elohhim/wyse-5070-ethernet-adapter/wyse-cnd-tek-adapter.scad

//
// File:    wyse-cnd-tek-adapter.scad
// Project: Dell Wyse 5070 2nd Ethernet Adapter Adapter
// Desc:    Adapter that holds CND-TEK T-shaped NIC daughter board
//

use <cnd-tek-nic.scad>
include <wyse-ethernet.scad>
