elohhim/wyse-5070-ethernet-adapter/(commit log)

2026-05-04 Add CND-TEK NIC adapter
    T-shaped PCB (30x20mm, 4.5mm wide x 11mm deep cutouts) with
    16x16x11mm ethernet jack. Includes NIC mock-up, adapter, and
    build integration.
    [cnd-tek-nic.scad, wyse-cnd-tek-adapter.scad, wyse-ethernet.scad]
2026-05-04 Update CND-TEK NIC with precise measurements
    PCB 30.6x20.1mm, 1.6mm thick. Ethernet jack 16.2x15x11.2mm.
    Wide section 8.8mm deep. Adjusted baffle height for thicker PCB.
    [cnd-tek-nic.scad, wyse-ethernet.scad]
2026-05-04 Switch CND-TEK to dual side snaps to clear flat cable connector
    Center snap would collide with the flat cable plug 1mm from
    rear edge. Side snaps sit in the T-shape cutout notches instead.
    Also reduced rear trough ledge to 3mm to avoid solder joints.
    [wyse-ethernet.scad]
2026-05-04 Fix CND-TEK snap sizing to clear flat cable plug
    5.7mm wide side snaps at 1mm from each edge leave 17.2mm center
    clearance for the 17mm plug. Rear trough ledge set to 0 to clear
    protruding solder pins.
    [wyse-ethernet.scad]
2026-05-04 Fix CND-TEK trough to support snap mounting points
    Two-zone trough: wide front zone with 7mm side ledges to support
    the side snaps, narrow rear zone with 3mm ledges and no rear
    ledge to clear solder pins.
    [wyse-ethernet.scad]
